mineda-support/ICPS2023_5/Technology/doc/PDK_minimalFabSOICMOS.pdf

ICPS2023Ver1.0

# minimal Fab SOI-CMOS PDK

## Minimal Fab PDK Authors

Oct. 31, 2023

ICPS2023Ver1.0

## Contents of minimal Fab SOI-CMOS PDK

## - Documentation 1. Device/Process Explanation 2. Device Characteristics 3. Design Manual - Electrical Data 1. SPICE Model 2. PCELL 3. DRC/LVS Rule

ICPS2023Ver1.0

## Contents of minimal Fab SOI-CMOS PDK

## - Documentation 1. Device/Process Explanation 2. Device Characteristics 3. Design Manual - Electrical Data 1. SPICE Model 2. PCELL 3. DRC/LVS Rule

## Cross-Sectional View of minimal Fab SOI-CMOS

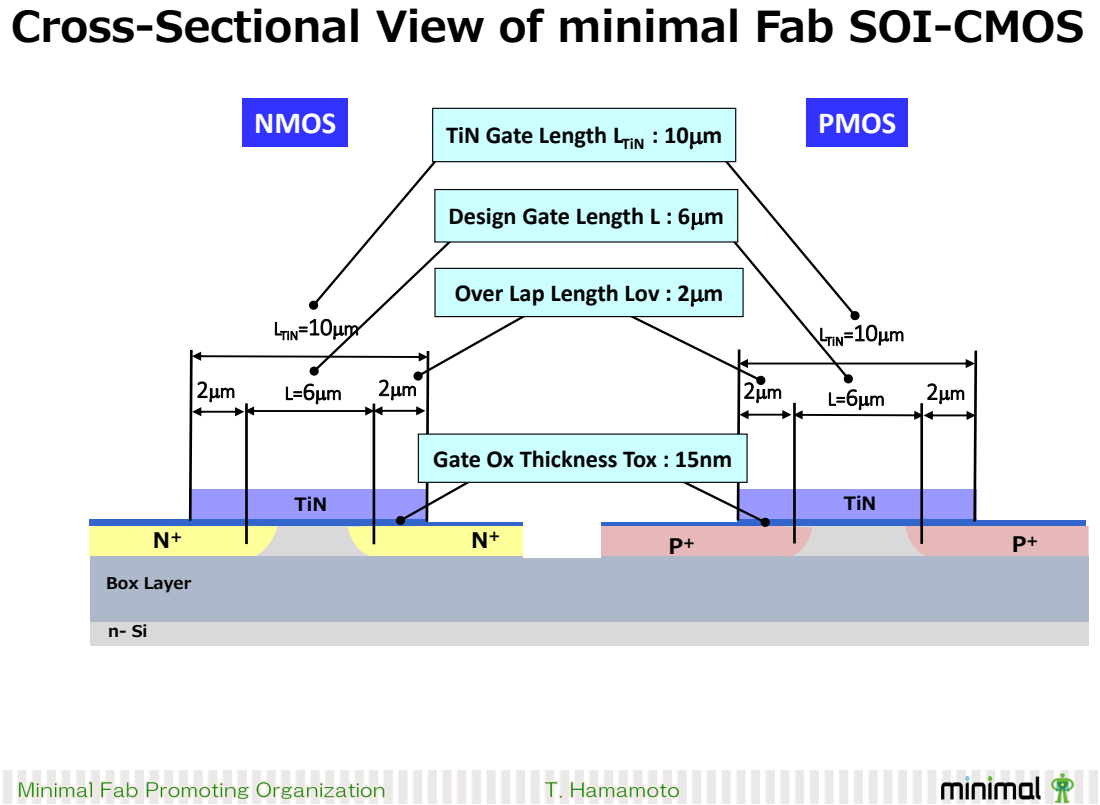
[picture p1: page 4]
LTiN=10mm; NMOS; PMOS; Box Layer; TiN

TiN Gate Length LTiN : 10mm

Design Gate Length L : 6mm

Over Lap Length Lov : 2mm

Gate Ox Thickness Tox : 15nm

## Fabrication Process of SOI-CMOS - Gate Last Formation -

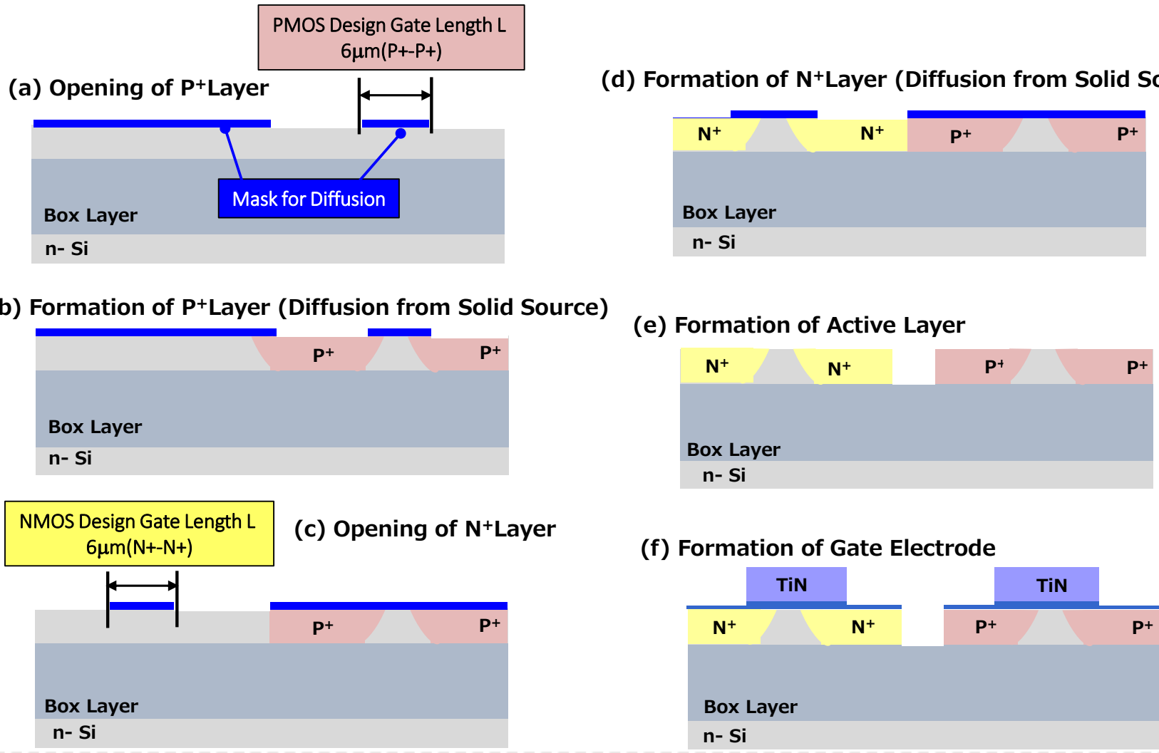
[picture p2: figure]
Box Layer; TiN; (a) Opening of P⁺Layer; (c) Opening of N⁺Layer; (e) Formation of Active Layer; (f) Formation of Gate Electrode; PMOS Design Gate Length L 6mm(P+-P+); NMOS Design Gate Length L 6mm(N+-N+); Mask for Diffusion

(b) Formation of P⁺Layer (Diffusion from Solid Source)

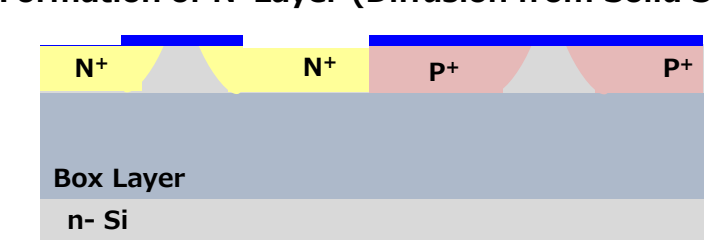
[picture p3: figure]

(d) Formation of N⁺Layer (Diffusion from Solid Source)

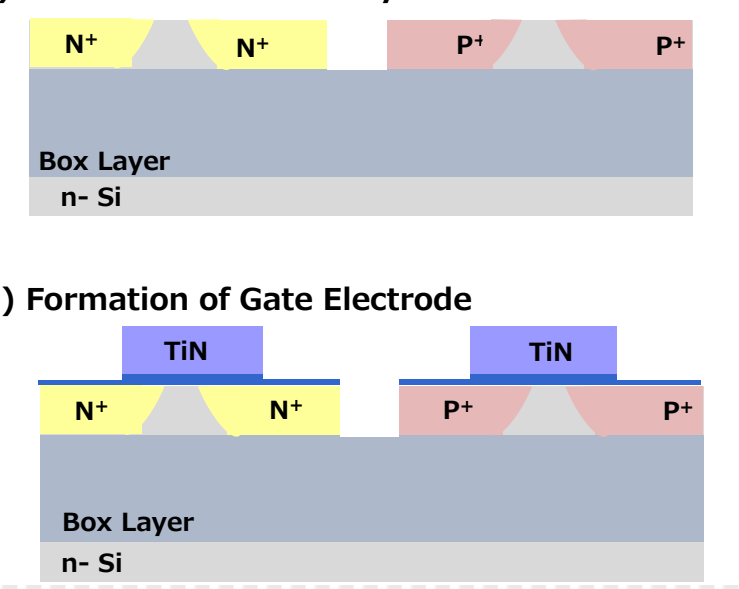
[picture p4: figure]

ICPS2023Ver1.0

## Contents of minimal Fab SOI-CMOS PDK

## - Documentation 1. Device/Process Explanation 2. Device Characteristics 3. Design Manual - Electrical Data 1. SPICE Model 2. PCELL 3. DRC/LVS Rule

## Table of MOSFET Characteristics

Parameters | Dimensions | Bias | Typical Value | Units
NMOS
Threshold Voltage | L/W=6/24 | Vds=0.05V | 0.25 | V
Idsat | L/W=6/24 | Vds=Vgs=3V | 62.5 | mA/mm
Subthreshold Slope | L/W=6/24 | | 71 | mV/dec
BVDSS | L/W=6/24 | | >7 | V
PMOS
Threshold Voltage | L/W=6/24 | Vds=-0.05V | -0.71 | V
Idsat | L/W=6/24 | Vds=Vgs=-3V | 12.9 | mA/mm
Subthreshold Slope | L/W=6/24 | | 65 | mV/dec
BVDSS | L/W=6/24 | | >7 | V

Ta=25℃

## Table of Sheet & Contact Resistance

Parameters | Dimensions | Bias | Typical Value | Units
Sheet Resistance
N+Diffusion | W/L=46.5mm/13mm | 2V | 180 | W/sq
P+Diffusion | W/L=46.5mm/13mm | 2V | 1.2K | W/sq
TiN | W/L=46.5mm/13mm | 2V | 20 | W/sq
Al | W/L=48mm/6mm | 10mA | 0.20 | W/sq
Contact Resistance
Al-N+ | 5mm×5mm | 10mA | 150 | W
Al-P+ | 5mm×5mm | 10mA | 200 | W
Al-TiN | 5mm×5mm | 10mA | 0.9 | W

Ta=25℃

## Table of Gate Oxide

Parameters | Dimensions | Bias | Typical Value | Units
Cox | Gate N | 2V | 2.3 | fF/mm2
Cox | Gate P | -2V | 2.3 | fF/mm2
BVox | Gate N | | >7 | V
BVox | Gate P | | >-7 | V

Ta=25℃

## Table of MOSFET Capacitance

Parameters | Dimensions | Bias | Typical Value | Units
NFET Overlap Cap. | 100mm×100mm | 2V | 5 | fF/mm
PFET Overlap Cap. | 100mm×100mm | -2V | 6.8 | fF/mm
NFET Diffusion Cap. | 100mm×100mm | 2V | 0.086 | fF/mm2
PFET Diffusion Cap. | 100mm×100mm | -2V | 0.086 | fF/mm2

## NFET VDID/VGID Characteristics (L/W=6mm/24mm)

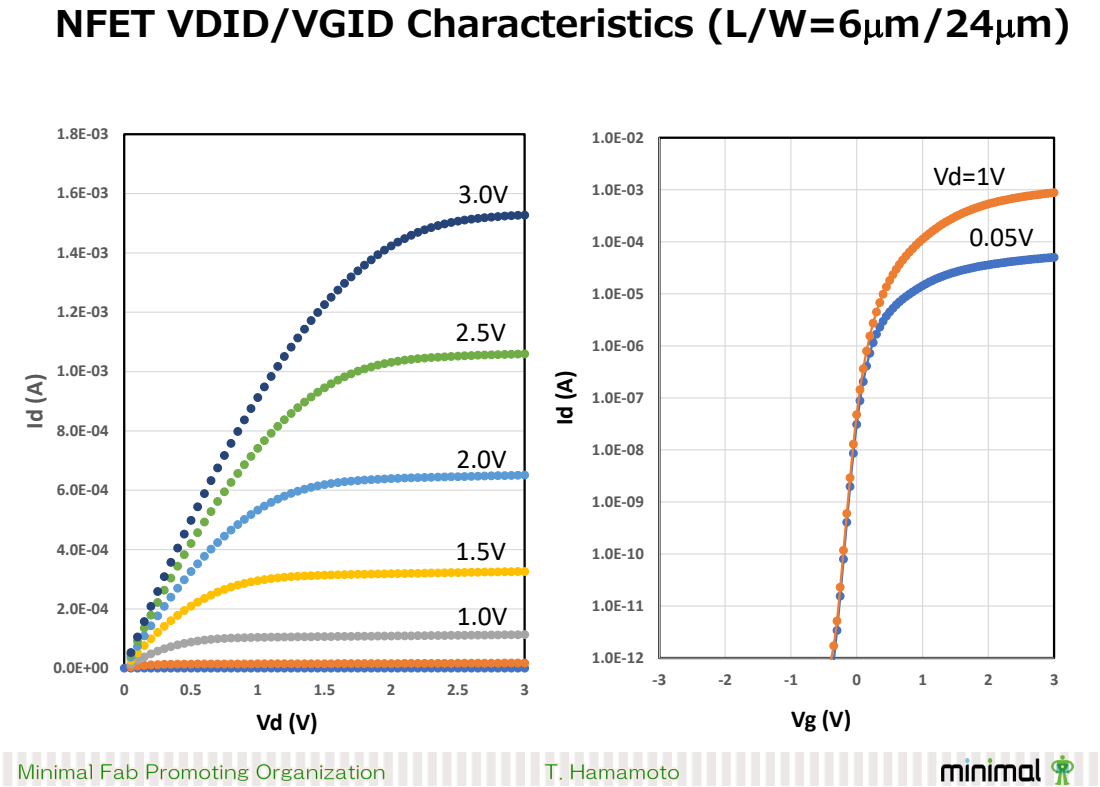
[picture p5: page 10]

## PFET VDID/VGID Characteristics (L/W=6mm/24mm)

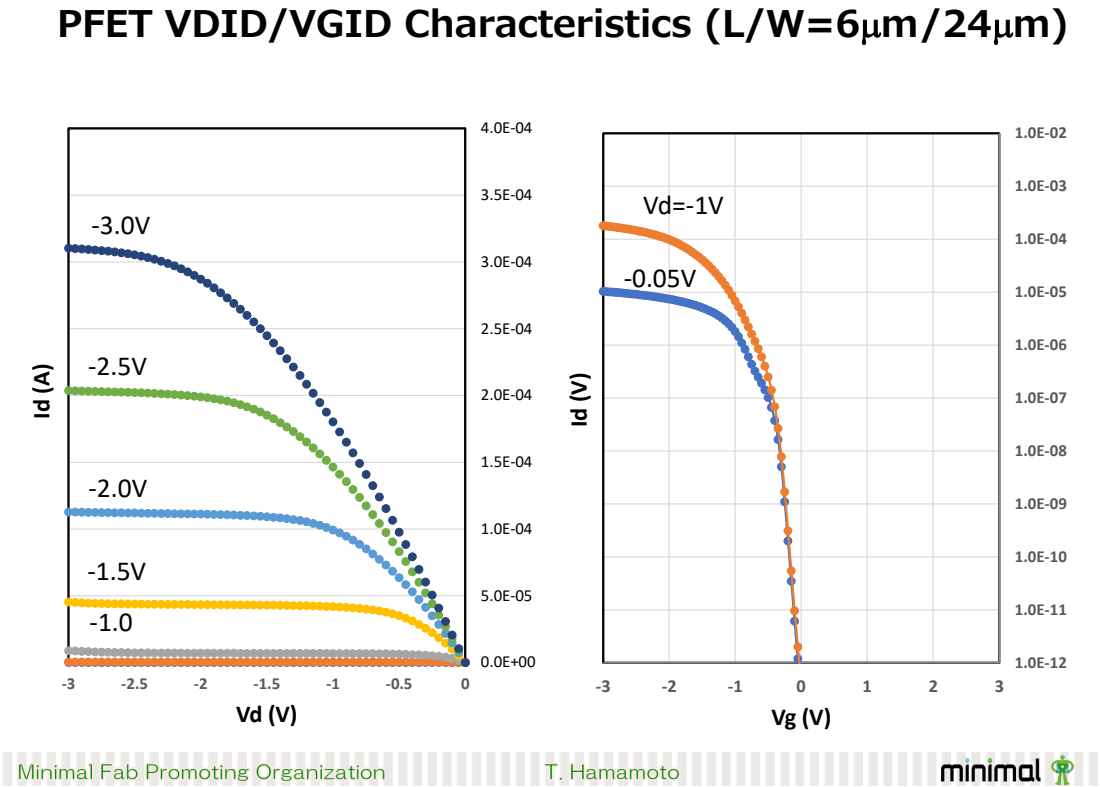
[picture p6: page 11]

## Measured vs SPICE Model

## NFET VDID/VGID Characteristics (L/W=6mm/24mm)

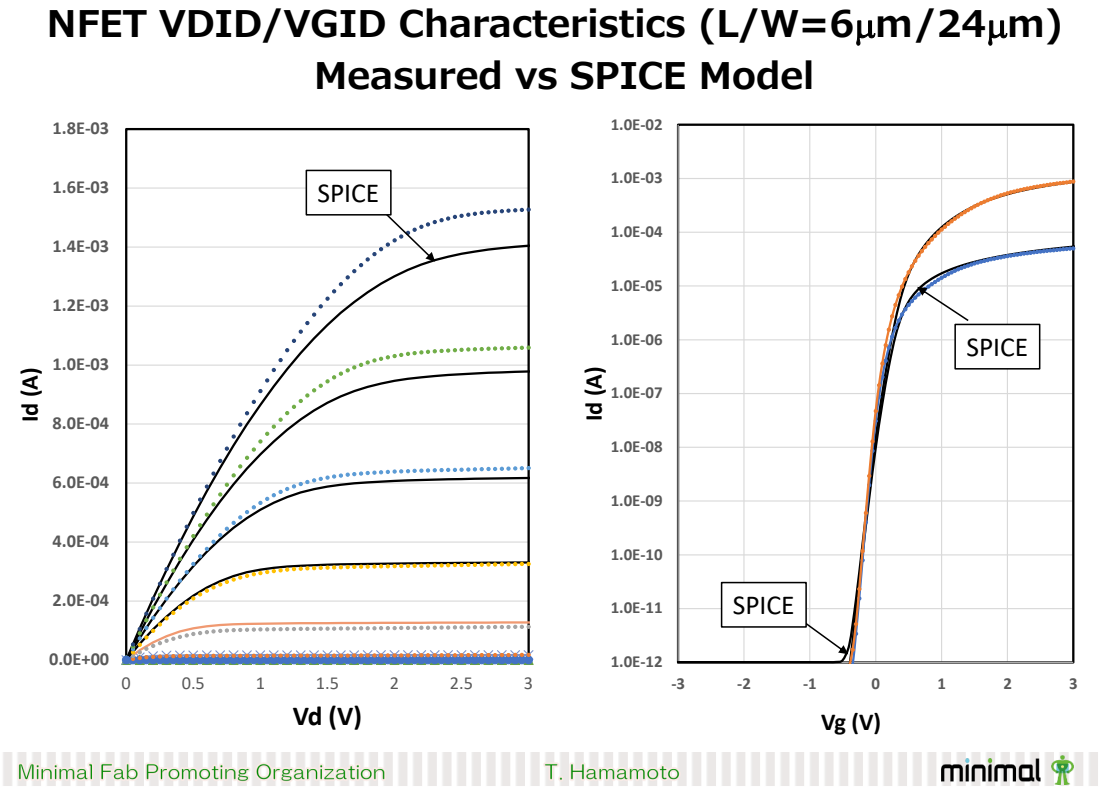
[picture p7: page 12]
SPICE

## Measured vs SPICE Model

## PFET VDID/VGID Characteristics (L/W=6mm/24mm)

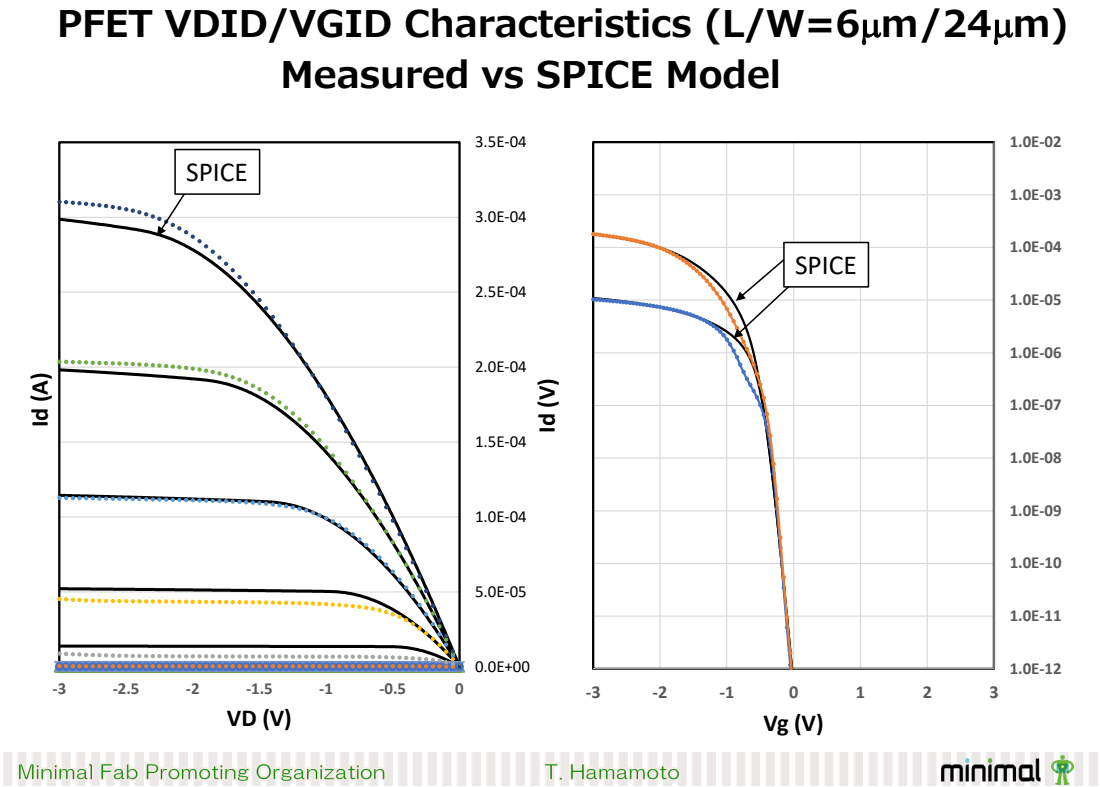
[picture p8: page 13]
SPICE

ICPS2023Ver1.0

## Contents of minimal Fab SOI-CMOS PDK

## - Documentation 1. Device/Process Explanation 2. Device Characteristics 3. Design Manual - Electrical Data 1. SPICE Model 2. PCELL 3. DRC/LVS Rule

Name | Symbol | L(mm) | W(mm) | Spice Model | Symbol of PCELL | Contents
NMOS | NMOS | 6～40mm | 13～40mm | MF_NMOS.txt | Nch
PMOS | PMOS | 6～40mm | 13～40mm | MF_PMOS.txt | Pch
Bridge | BR | 25～100mm | 10～20mm | MF_NMOS.txt | Bridge | TiN wiring for Local Bridge
Nbridge | NB | 25～100mm | 10～20mm | MF_NMOS.txt | Nbridge | N-Diffused Layer wiring for Local Bridge
Ndiff_cap | ND | 25～100mm | 25～100mm | MF_NMOS.txt | Ndiff_cap | Gate-N-Diffused Layer for Capacitor
Pdiff_cap | PD | 25～100mm | 25～100mm | MF_PMOS.txt | Pdiff_cap | Gate-P-Diffused Layer for Capacitor
R_ndiff | RN | 25～100mm | 10～20mm | MF_NMOS.txt | R_ndiff | N-Diffused layer for Resistance
R_pdiff | RP | 25～100mm | 10～20mm | MF_PMOS.txt | R_pdiff | P-Diffused layer for Resistance
TiN_cap | TI | 25～100mm | 25～100mm | MF_NMOS.txt | TiN_cap | Gate-Al Capacitor

## Table of Device List

## Cross-Sectional View of PCELL (1)

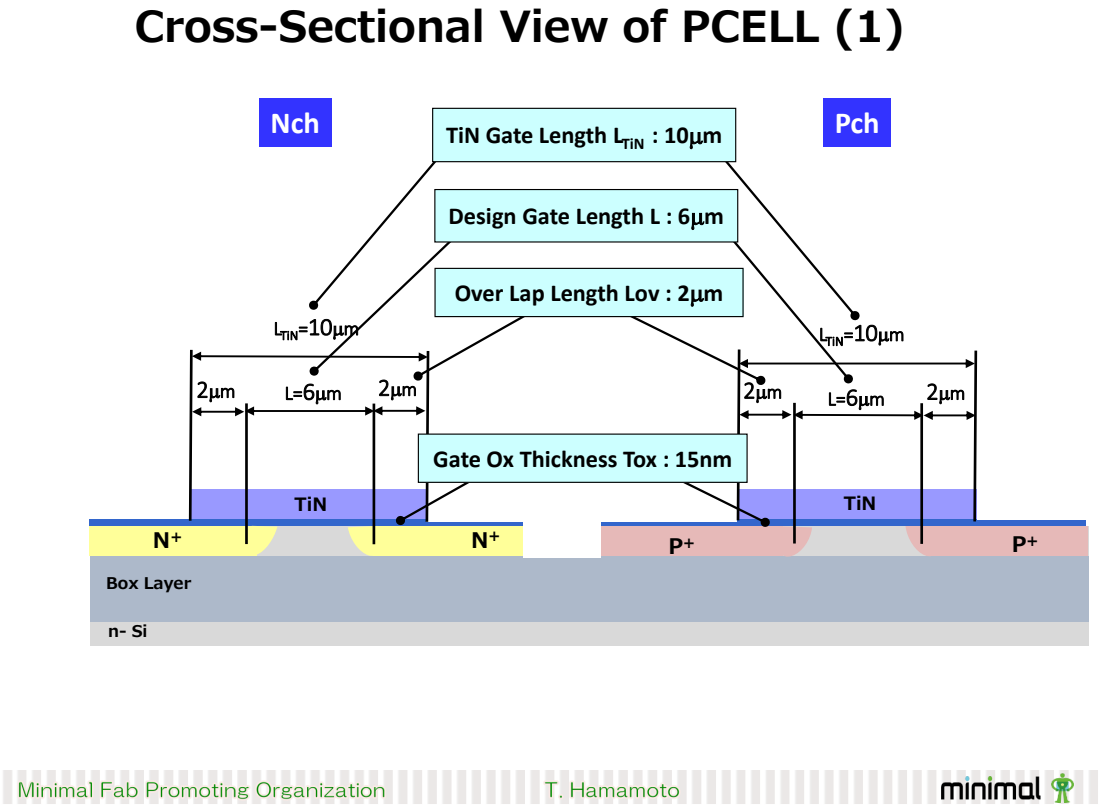
[picture p9: page 16]
LTiN=10mm; Nch; Pch; Box Layer; TiN

TiN Gate Length LTiN : 10mm

Design Gate Length L : 6mm

Over Lap Length Lov : 2mm

Gate Ox Thickness Tox : 15nm

## Bridge(BR) : Local wiring by TiN

## Cross-Sectional View of PCELL (2)

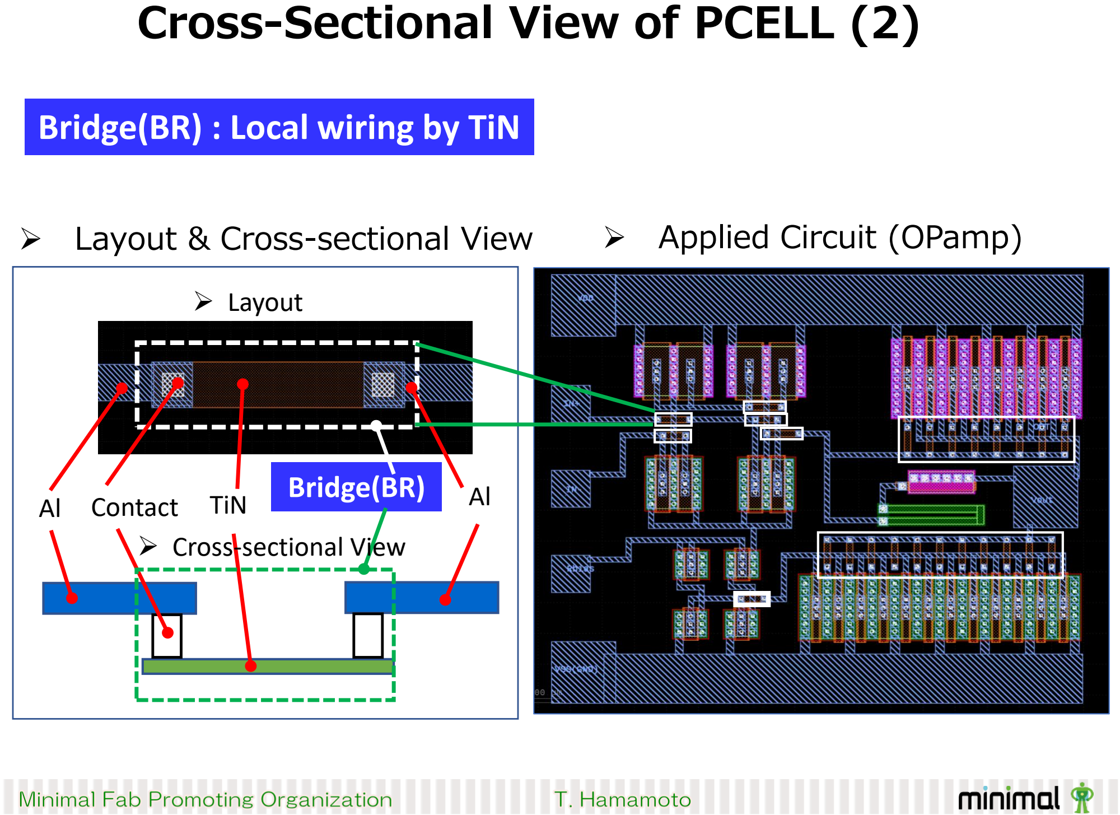
[picture p10: page 17]

- | Layout & Cross-sectional View | ➢ | Applied Circuit (OPamp)
TiN | Contact | Al Al Contact

Bridge(BR)

- Layout
- Cross-sectional View

## Cross-Sectional View of PCELL (3)

NBridge(NB) :
Local wiring by n+

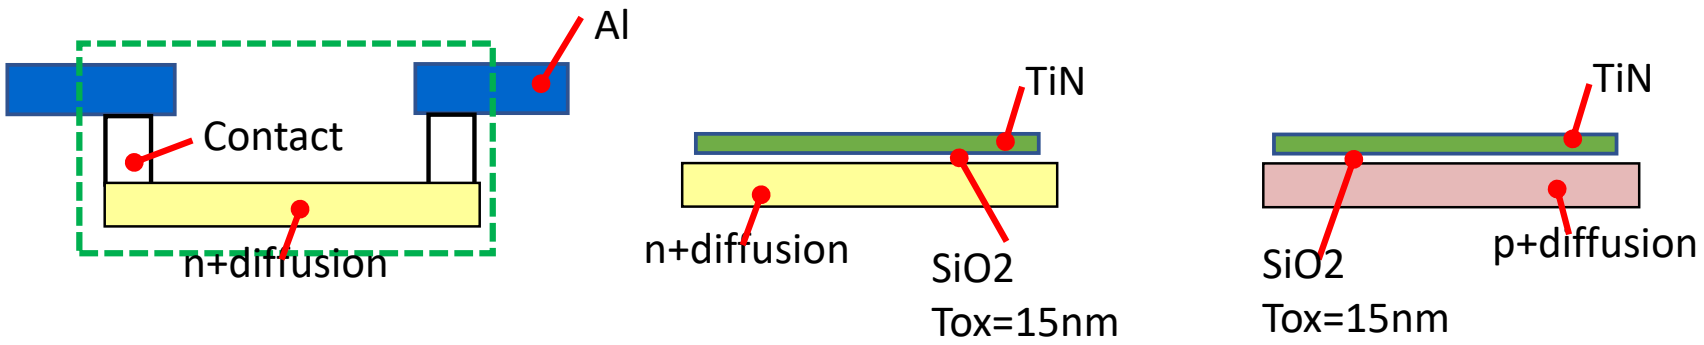
[picture p11: figure]
n+diffusion; p+diffusion SiO2; Tox=15nm; SiO2 Tox=15nm; TiN; Contact

TiN_cap(TI) :
Capacitor btw Al & TiN

R_ndiff(RN) :
Resistance by n+

Ndiff_cap(ND) :
Capacitor btw TiN & n+

Pdiff_cap(PD) :
Capacitor btw TiN & p+

R_pdiff(RP) :
Resistance by p+

n+diffusion
rs=200W/□

P+diffusion
rs=400W/□

TiN

Al

SiO2(TEOS)
Tox=300nm

Drawn Layer Name | GDS Layer No. | Data W/B | Used Layer | Contents
NMOS | PMOS | BR | NB | ND | PD | RN | RP | TI
Alignment Mark | 1 | W
N-channel | 13 | W | 〇 | | | | | | | | | Channel doping of NMOS
P-Diff (PDF) | 2 | W | | 〇 | | | | 〇 | | 〇 | | Source/Drain doping of PMOS
N-Diff (NDF) | 3 | W | 〇 | | | 〇 | 〇 | | 〇 | | | Source/Drain doping of NMOS
SOI | 4 | B | 〇 | 〇 | | 〇 | 〇 | 〇 | 〇 | 〇 | | Active Layer (Silicon Island
TiN-Gate | 5 | B | 〇 | 〇 | 〇 | | | | | | 〇 | Gate
Contact (CNT) | 6 | W | 〇 | 〇 | 〇 | 〇 | 〇 | 〇 | 〇 | 〇 | 〇 | Source/Drain/Gate Contact
Al | 7 | B | 〇 | 〇 | 〇 | 〇 | 〇 | 〇 | 〇 | 〇 | 〇 | Al wiring

## Table of Drawn Layers for Each Device

Description | Symbol | Layout Rule (mm)
TiN Minimum Gate Width | W1 | 10
SOI Minimum Width | W2 | 13
CNT Size | S1 | 5
TiN-NDF(or PDF) Overlap | m1 | 2
TiN Minimum Fringe | m2 | 4
SOI-NDF(or PDF) Minimum Enclosure | m3 | 2
Gate TiN-CNT Distance | d1 | 8

## Layout Rule (1) : Device Layer

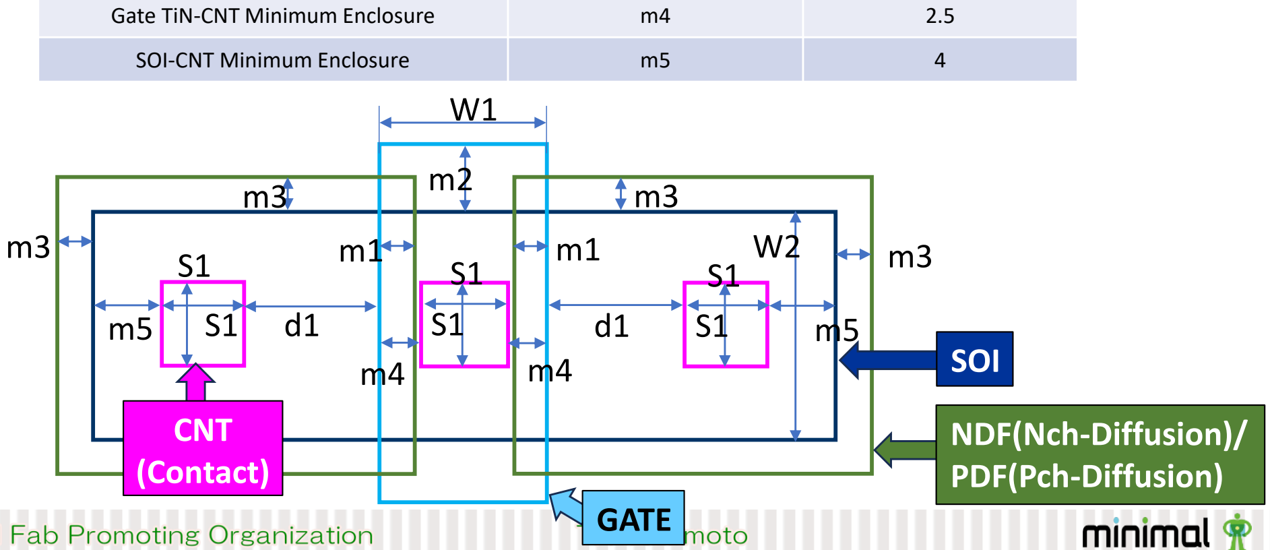
[picture p12: figure]
Gate TiN-CNT Minimum Enclosure; SOI-CNT Minimum Enclosure; GATE; NDF(Nch-Diffusion)/ PDF(Pch-Diffusion); SOI; CNT (Contact)

Description | Symbol | Layout Rule (mm)
Al Minimum Width | W3 | 6
Al Minimum Space | S2 | 4
Al-CNT Minimum Enclosure | m6 | 4
Al-Gate CNT Minimum Enclosure | m7 | 2.5
TiN Minimum Width | | 6
TiN Minimum Space | | 6
SOI Minimum Width | | 6
SOI Minimum Space | | 4

## Layout Rule (2) : Wiring Layer

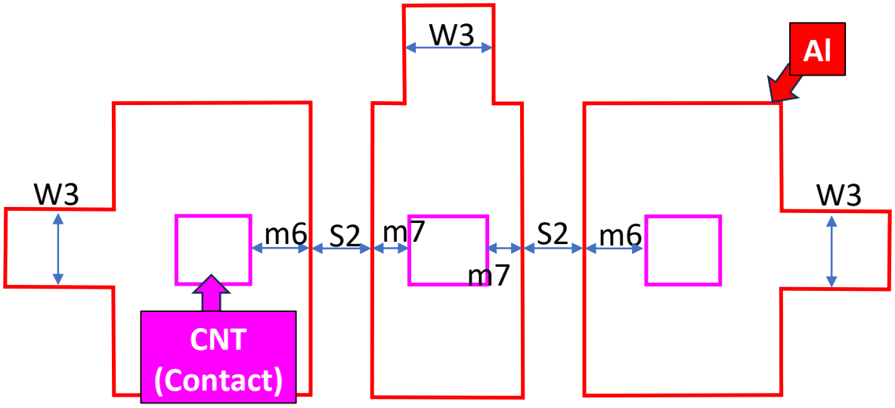
[picture p13: figure]
CNT (Contact)

# END
