mineda-support/ICPS2023_5/Samples/Semicon2023/NAND/floating_devices.asc

M1: NMOS_MIN; l=10.0U w=10.0U
M2: NMOS_MIN; l=10.0U w=10.0U
M3: NMOS_MIN; l=10.0U w=10.0U
M4: NMOS_MIN; l=10.0U w=10.0U
M5: NMOS_MIN; l=10.0U w=10.0U
M6: NMOS_MIN; l=10.0U w=10.0U
M7: NMOS_MIN; l=10.0U w=10.0U
M8: NMOS_MIN; l=10.0U w=10.0U
M9: NMOS_MIN; l=10.0U w=10.0U
M10: NMOS_MIN; l=10.0U w=10.0U
M11: NMOS_MIN; l=10.0U w=10.0U
M12: NMOS_MIN; l=10.0U w=10.0U
M13: NMOS_MIN; l=10.0U w=10.0U
M14: PMOS_MIN; l=10u w=40u
M15: PMOS_MIN; l=10u w=40u
M16: PMOS_MIN; l=10u w=40u
M17: PMOS_MIN; l=10u w=40u
M18: PMOS_MIN; l=10u w=40u
M19: PMOS_MIN; l=10u w=40u
M20: PMOS_MIN; l=10u w=40u
M21: PMOS_MIN; l=10u w=40u
M22: PMOS_MIN; l=10u w=40u
M23: PMOS_MIN; l=10u w=40u
M24: PMOS_MIN; l=10u w=40u
M25: PMOS_MIN; l=10u w=40u
M26: NMOS_MIN; l=10.0U w=10.0U
M27: PMOS_MIN; l=10u w=40u
M28: PMOS_MIN; l=10u w=40u
Named nets: x
