mineda-support/ICPS2023_5/Samples/Semicon2023/NAND/nand_min_and_floating_devices.asc

M1: PMOS_MIN; l=10.0U w=40.0U
M2: PMOS_MIN; l=10.0U w=40.0U
M3: NMOS_MIN; l=10.0U w=10.0U
M4: NMOS_MIN; l=10.0U w=10.0U
X1: floating_devices
Named nets: A, B, Y, VDD, VSS, 0
.tran 1m
.include %HOMEPATH%\\KLayout\\salt\\ICPS2023_5\\Technology\\tech\\models\\SOI_CMOS
