mineda-support/ICPS2023_5/Samples/Semicon2023/NAND/nand_min_tb.asc

V1: voltage; PULSE(0 3 0 0 0 2m 4m)
V2: voltage; PULSE(0 3 0 0 0 1m 2m)
V3: voltage; 3
X1: nand_min
Named nets: 0, out, A, B
.include %HOMEPATH%\\KLayout\\salt\\ICPS2023_5\\Technology\\tech\\models\\SOI_CMOS
.tran 10m
