mineda-support/ICPS2023_5/(list of files, drawings)

Other design files:
Technology/tech/tech.lyt
