mineda-support/ICPS2023_5/(commit log)

2023-05-13 initial version: PCell v0.2 corrected diff to gate gap
    [tech.lyt]
2023-05-17 replaced Technology/tech/YSS_SOI.lyp w/ Technology/tech/ICPS_SOI.lyp
    [tech.lyt]
2023-08-01 PCell v0.46: disabled r_soi
    [tech.lyt]
2023-09-16 PCell v0.461: revived r_soi to subclass while disabled
    [tech.lyt]
2023-09-17 typo: DRC for Mineda2022_6 -> ICPS2023_5, fix for metalie_bridges and revert_from_metals, PCell v0.462: nch/pch added Minimum Dumbbell shaft length
    [tech.lyt]
2023-10-13 PCell v0.7, LVS v0.4: revised sheet resistance and unit cap values based on Hamamoto-san PDK document
2023-10-31 PDK_minimalFabSOICMOS.pdf updated w/ v.20231031, PDK reference manual 1st cut from PDKRev0.docx and made available from KLayout menu
2023-11-01 コンテスト用GDSです
2023-11-01 Replaced EXAMPLE_GDS/base_Rev.92.GDS with Samples/Semicon2023/base_contest2023.GDS
2023-11-02 nmosとpmosのゲート位置を合わせました
2023-11-03 remaining GPLv3 indication changed to Apache 2.0, NAND sample for semicon contest put under Samples/Semicon2023/NAND
2023-11-05 Samples/Semicon2023/NAND corrected: 2 nmos and 2 pmos added to nand_chip.asc
2023-11-05 Samples/Semicon2023/NAND: another reference circuit sample (nand_min_and_floating_devices + floating_devices)
2023-11-15 PCell v0471: show resistance values for Bridge (made of TiN) and NBridge (Ndiff)
2024-01-11 SPICE models revised to suppress inapporopriate error messages
    [tech.lyt]
2024-11-07 drc 0.32: ML1 minimum width changed from 5.0um to 6.0um
    [tech.lyt]
